mkdorff/subserve/design/Home Pressed.png

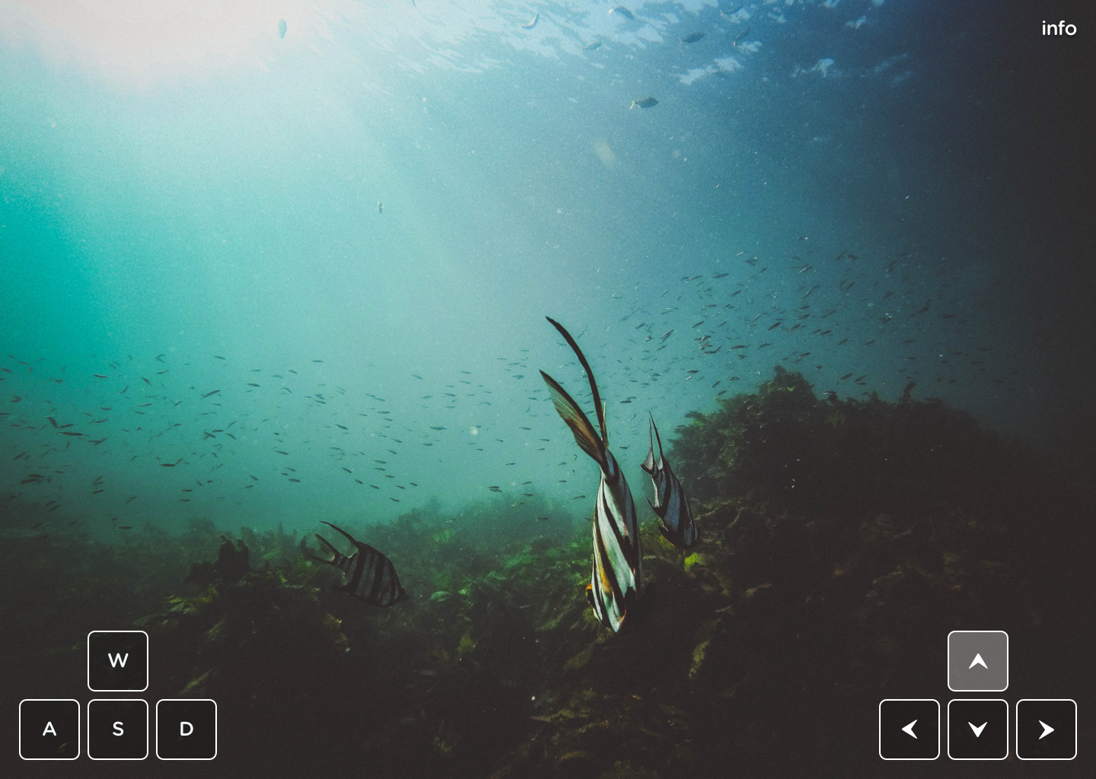
design/Home Pressed.png
