mkdorff/subserve/design/Home Overlay.png

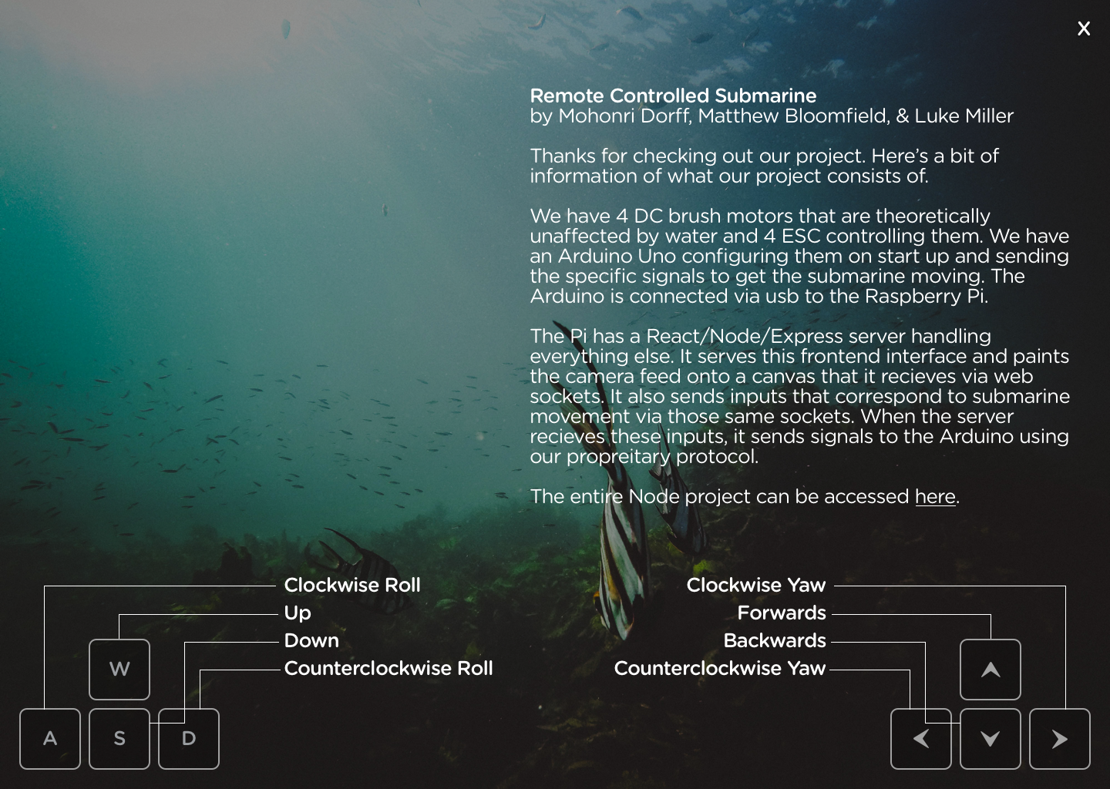
design/Home Overlay.png
