mkdorff/subserve/(commit log)

2017-11-14 added fonts, flushed out client structure, few design files, and arduinoserial output. -- not sure if that last one works yet
2017-11-14 Added README and barebones of camera helper.
2017-11-15 added socket.io server depn
2017-11-15 slimmed down server a ton, added helpers and socket emitters for keypresses
2017-11-15 Added error handling on serial comm, cleaned up server and hooked up socket input to serial out, removed unneeded depens
2017-11-16 Prepping canvas, barebones of camera helper, setting up socket comm
2017-11-16 try listening for socket video feed
2017-11-17 got camera feed in proper format in through sockets
2017-11-17 Set up painting data from sockets to convas
2017-11-17 camera feed working! It's just super slow :(
2017-11-17 socket test
2017-11-17 emitting from camera helper function
2017-11-17 sped up camera feed and fixed video feed routing
